UlinduP/Lead_Acid_Battery_Charger/Bill of Materials.pdf

### Bill of Materials

Item | Quantity | Price(Rs.)
LM741CN/NOPB op-amp | 11 | 440.00
IN4728 zenor diode | 9 | 67.50
IRF530N | 3 | 240.00
3266W-1-5041F MULTITURN | 3 | 120.00
BC547B | 3 | 15.00
Resistors | 30 | 150.00
LQH55DN100M03L Inductor | 1 | 9.00
DS1E-S-DC24V Relay | 1 | 120.00
led | 2 | 10.00
capacitors | 10 | 125.00
PCB | | 1820.00
Enclosure | 1 | 700.00
Wires | | 400.00
Total | | 4216.50
