UlinduP/Lead_Acid_Battery_Charger/Solidworks/Battery Charger.SLDASM

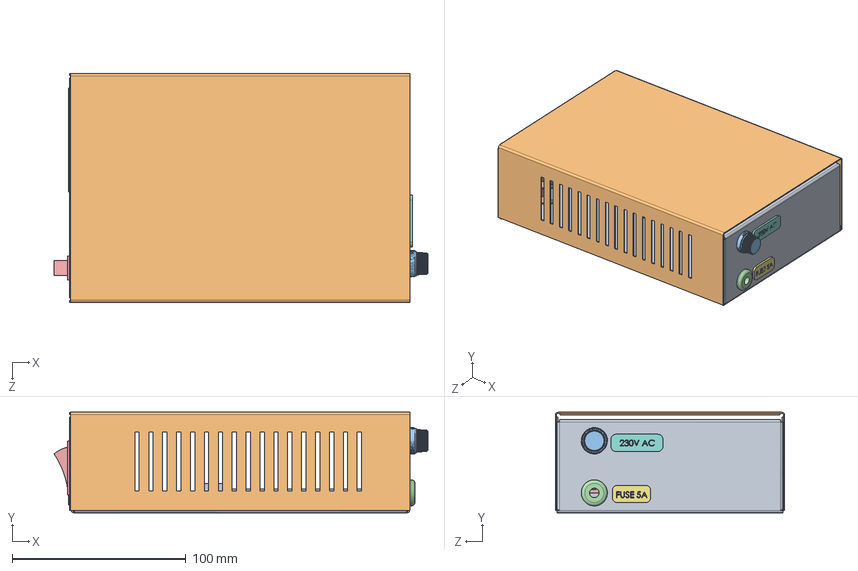
[picture p20: CAD file, 2023-08-15]
Solidworks/Battery Charger.SLDASM
215.3 x 57.9 x 132.0 mm
Copy of 02 Bottom Box1^Battery Charger
01 Top Cover
05 Fuse Holder
07 Wire Retaining Bush
10 Main Switch
11 Charging Name plate
12 Fuse Name
13 AC Name Plate
pcb
