UlinduP/Lead_Acid_Battery_Charger/Solidworks/10 Main Switch.SLDPRT

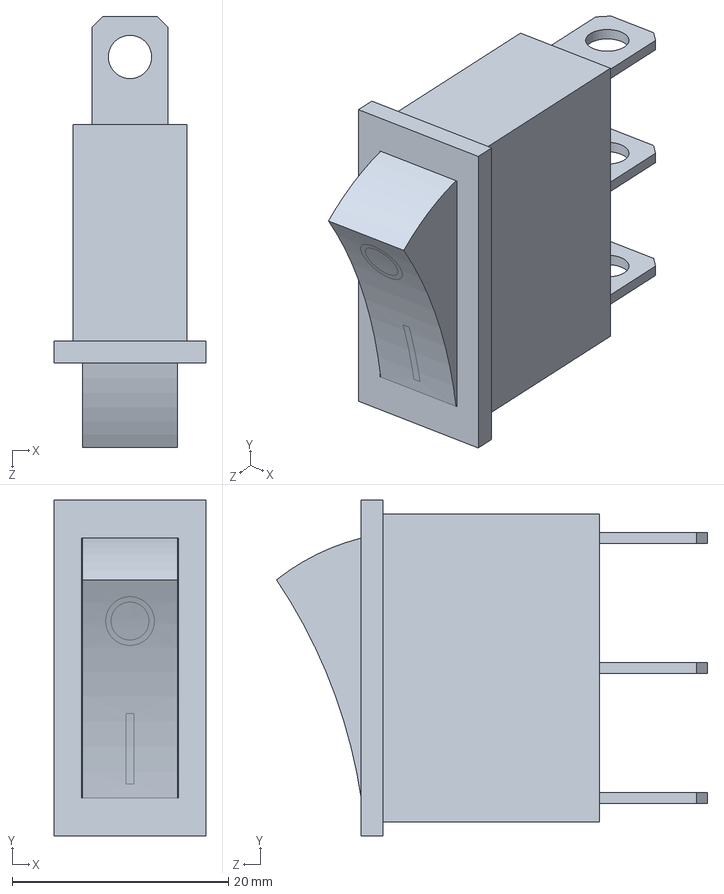
[picture p21: CAD file, 2023-08-15]
Solidworks/10 Main Switch.SLDPRT
14.0 x 31.0 x 39.8 mm
