UlinduP/Lead_Acid_Battery_Charger/Solidworks/01 Top Cover.SLDPRT

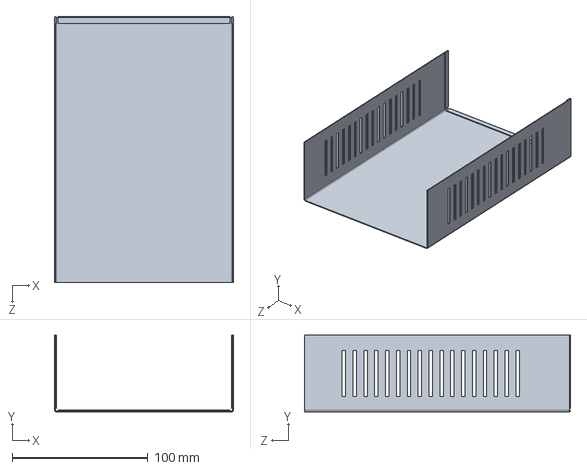
[picture p22: CAD file, 2023-08-15]
Solidworks/01 Top Cover.SLDPRT
132.0 x 56.7 x 196.0 mm
