UlinduP/Lead_Acid_Battery_Charger/Solidworks/pcb.SLDPRT

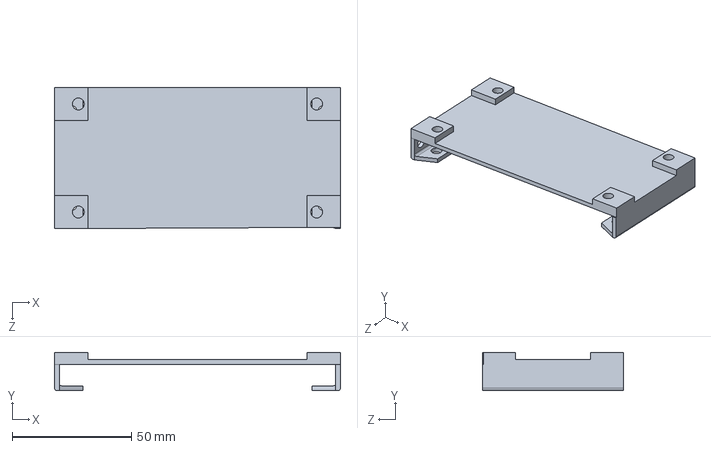
[picture p23: CAD file, 2023-08-15]
Solidworks/pcb.SLDPRT
120.0 x 16.0 x 59.3 mm
