UlinduP/Lead_Acid_Battery_Charger/Solidworks/13 AC Name Plate.SLDPRT

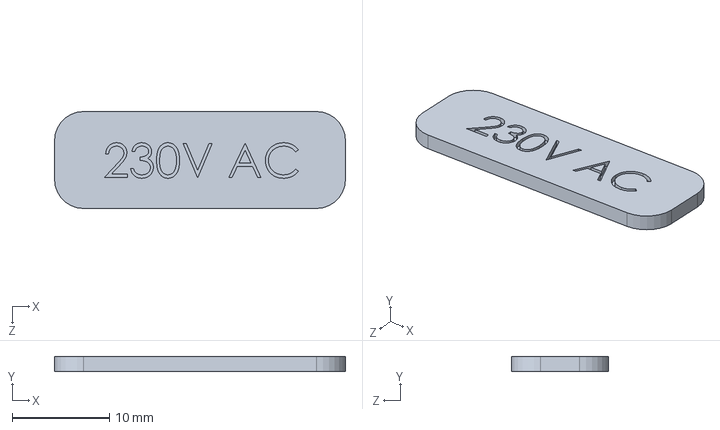
[picture p24: CAD file, 2023-08-15]
Solidworks/13 AC Name Plate.SLDPRT
30.0 x 1.50 x 10.0 mm
