UlinduP/Lead_Acid_Battery_Charger/Solidworks/07 Wire Retaining Bush.SLDPRT

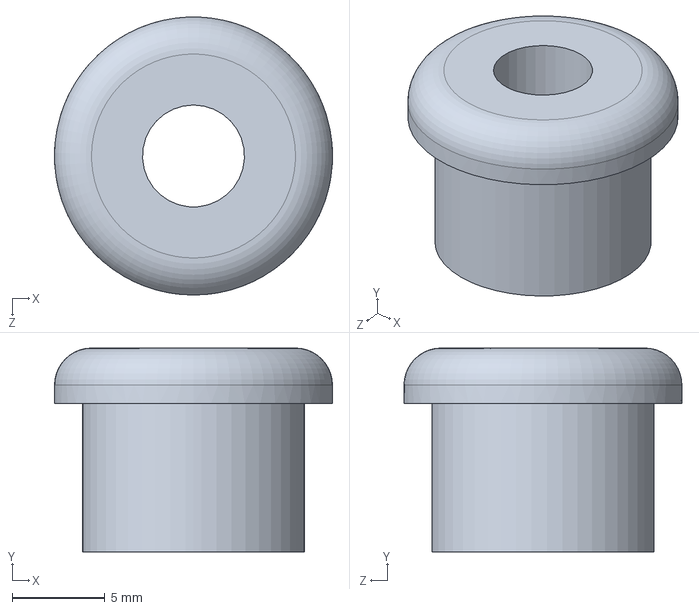
[picture p25: CAD file, 2023-08-15]
Solidworks/07 Wire Retaining Bush.SLDPRT
15.0 x 11.0 x 15.0 mm
