UlinduP/Lead_Acid_Battery_Charger/Solidworks/05 Fuse Holder.SLDPRT

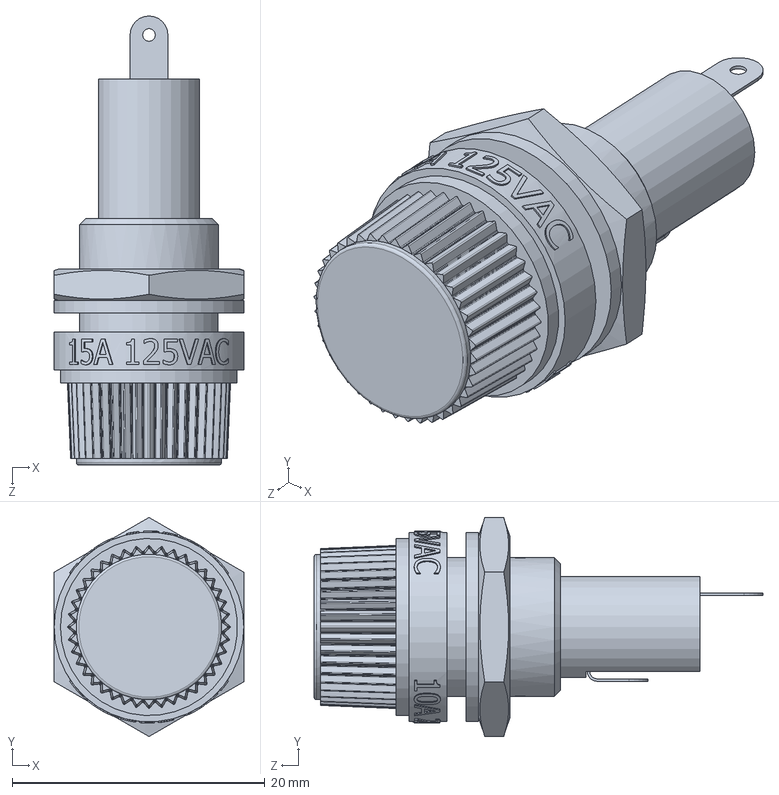
[picture p26: CAD file, 2023-08-15]
Solidworks/05 Fuse Holder.SLDPRT
15.0 x 17.3 x 35.5 mm
