UlinduP/Lead_Acid_Battery_Charger/Solidworks/02 Bottom Box.SLDPRT

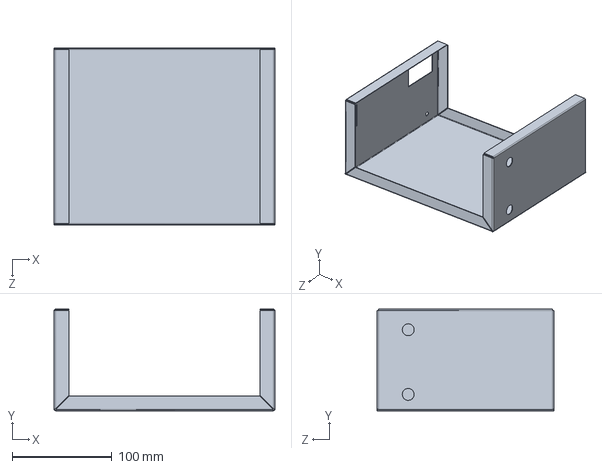
[picture p27: CAD file, 2023-08-15]
Solidworks/02 Bottom Box.SLDPRT
222.0 x 102.0 x 178.0 mm
