UlinduP/Lead_Acid_Battery_Charger/Solidworks/12 Fuse Name.SLDPRT

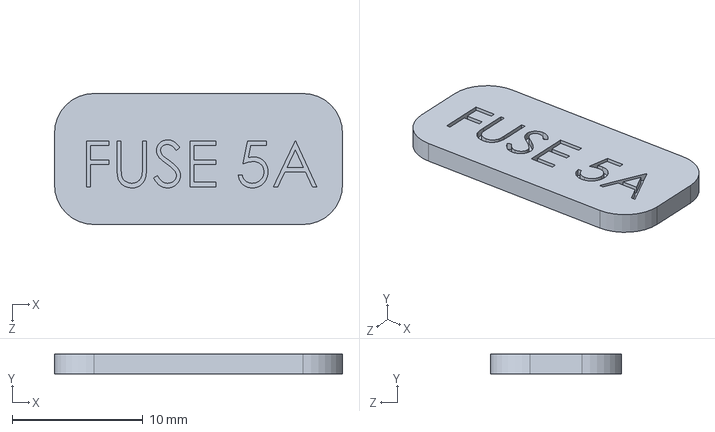
[picture p28: CAD file, 2023-08-15]
Solidworks/12 Fuse Name.SLDPRT
22.0 x 1.50 x 10.0 mm
