UlinduP/Lead_Acid_Battery_Charger/Solidworks/01 Top ver2.SLDPRT

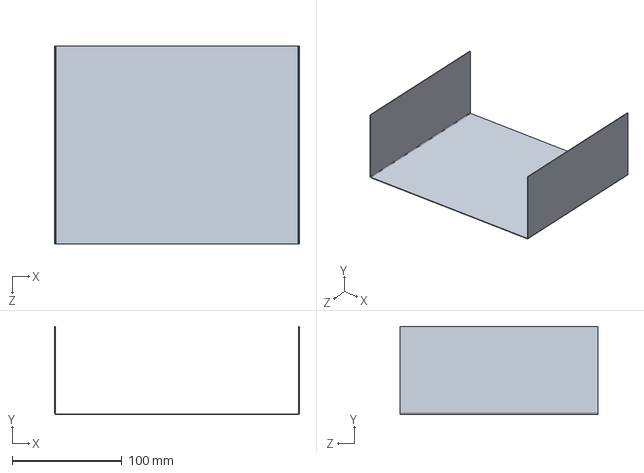
[picture p29: CAD file, 2023-08-15]
Solidworks/01 Top ver2.SLDPRT
223.0 x 80.1 x 180.0 mm
