UlinduP/Lead_Acid_Battery_Charger/Solidworks/11 Charging Name plate.SLDPRT

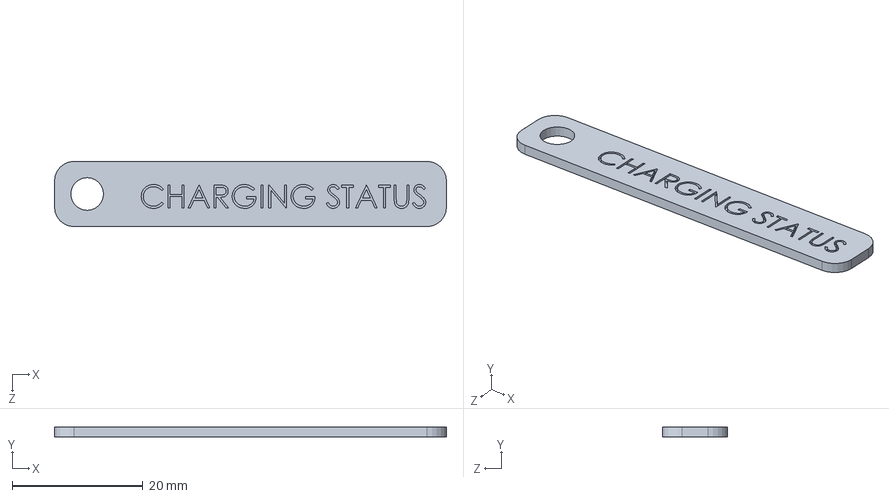
[picture p30: CAD file, 2023-08-15]
Solidworks/11 Charging Name plate.SLDPRT
60.0 x 1.50 x 10.0 mm
