UlinduP/Lead_Acid_Battery_Charger/(list of files, drawings)

Other design files:
final_simulation.ms14
schematics/sheet_buck.PcbDoc
schematics/sheet_buck.SchDoc
schematics/sheet_cc.PcbDoc
schematics/Sheet_cc.SchDoc
schematics/sheet_cv.PcbDoc
schematics/Sheet_cv.SchDoc
schematics/sheet_pwm.PcbDoc
schematics/Sheet_pwm.SchDoc
schematics/sheet_reg.PcbDoc
schematics/sheet_reg.SchDoc
schematics/sheet_switch.PcbDoc
schematics/Sheet_switch.SchDoc
